zenitmusic/custom_TWIPR/robot_blackboard/sensor_board.png

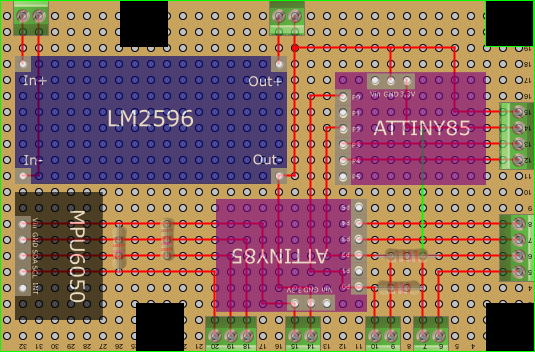
robot_blackboard/sensor_board.png
