zenitmusic/custom_TWIPR/robot_blackboard/motor_board.png

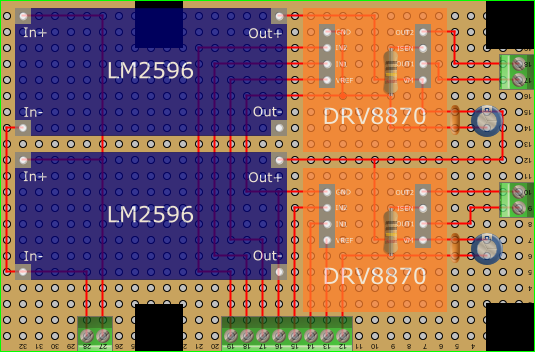
robot_blackboard/motor_board.png
