zenitmusic/custom_TWIPR/README.md

# custom_TWIPR
Custom hard- and software platform for a Two-wheeled Inverted-pendulum Robot
