zenitmusic/custom_TWIPR/robot_schematics.png

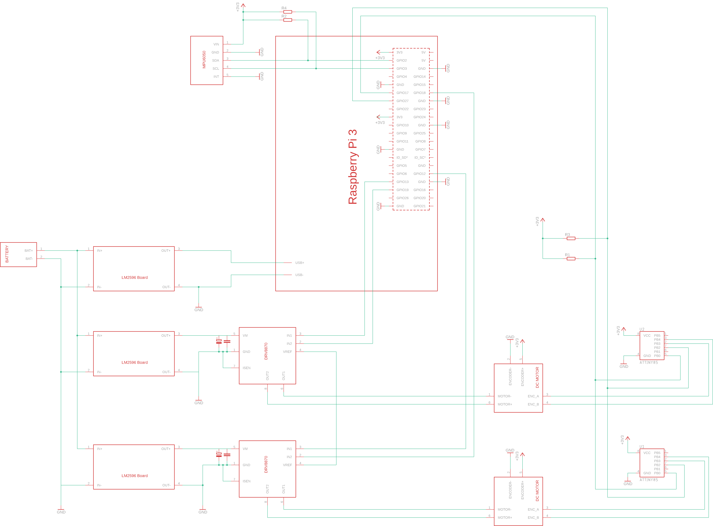
robot_schematics.png
