zenitmusic/custom_TWIPR/robot_eagle/robot.sch

## EAGLE design robot_eagle/robot.sch (2019-02-14)

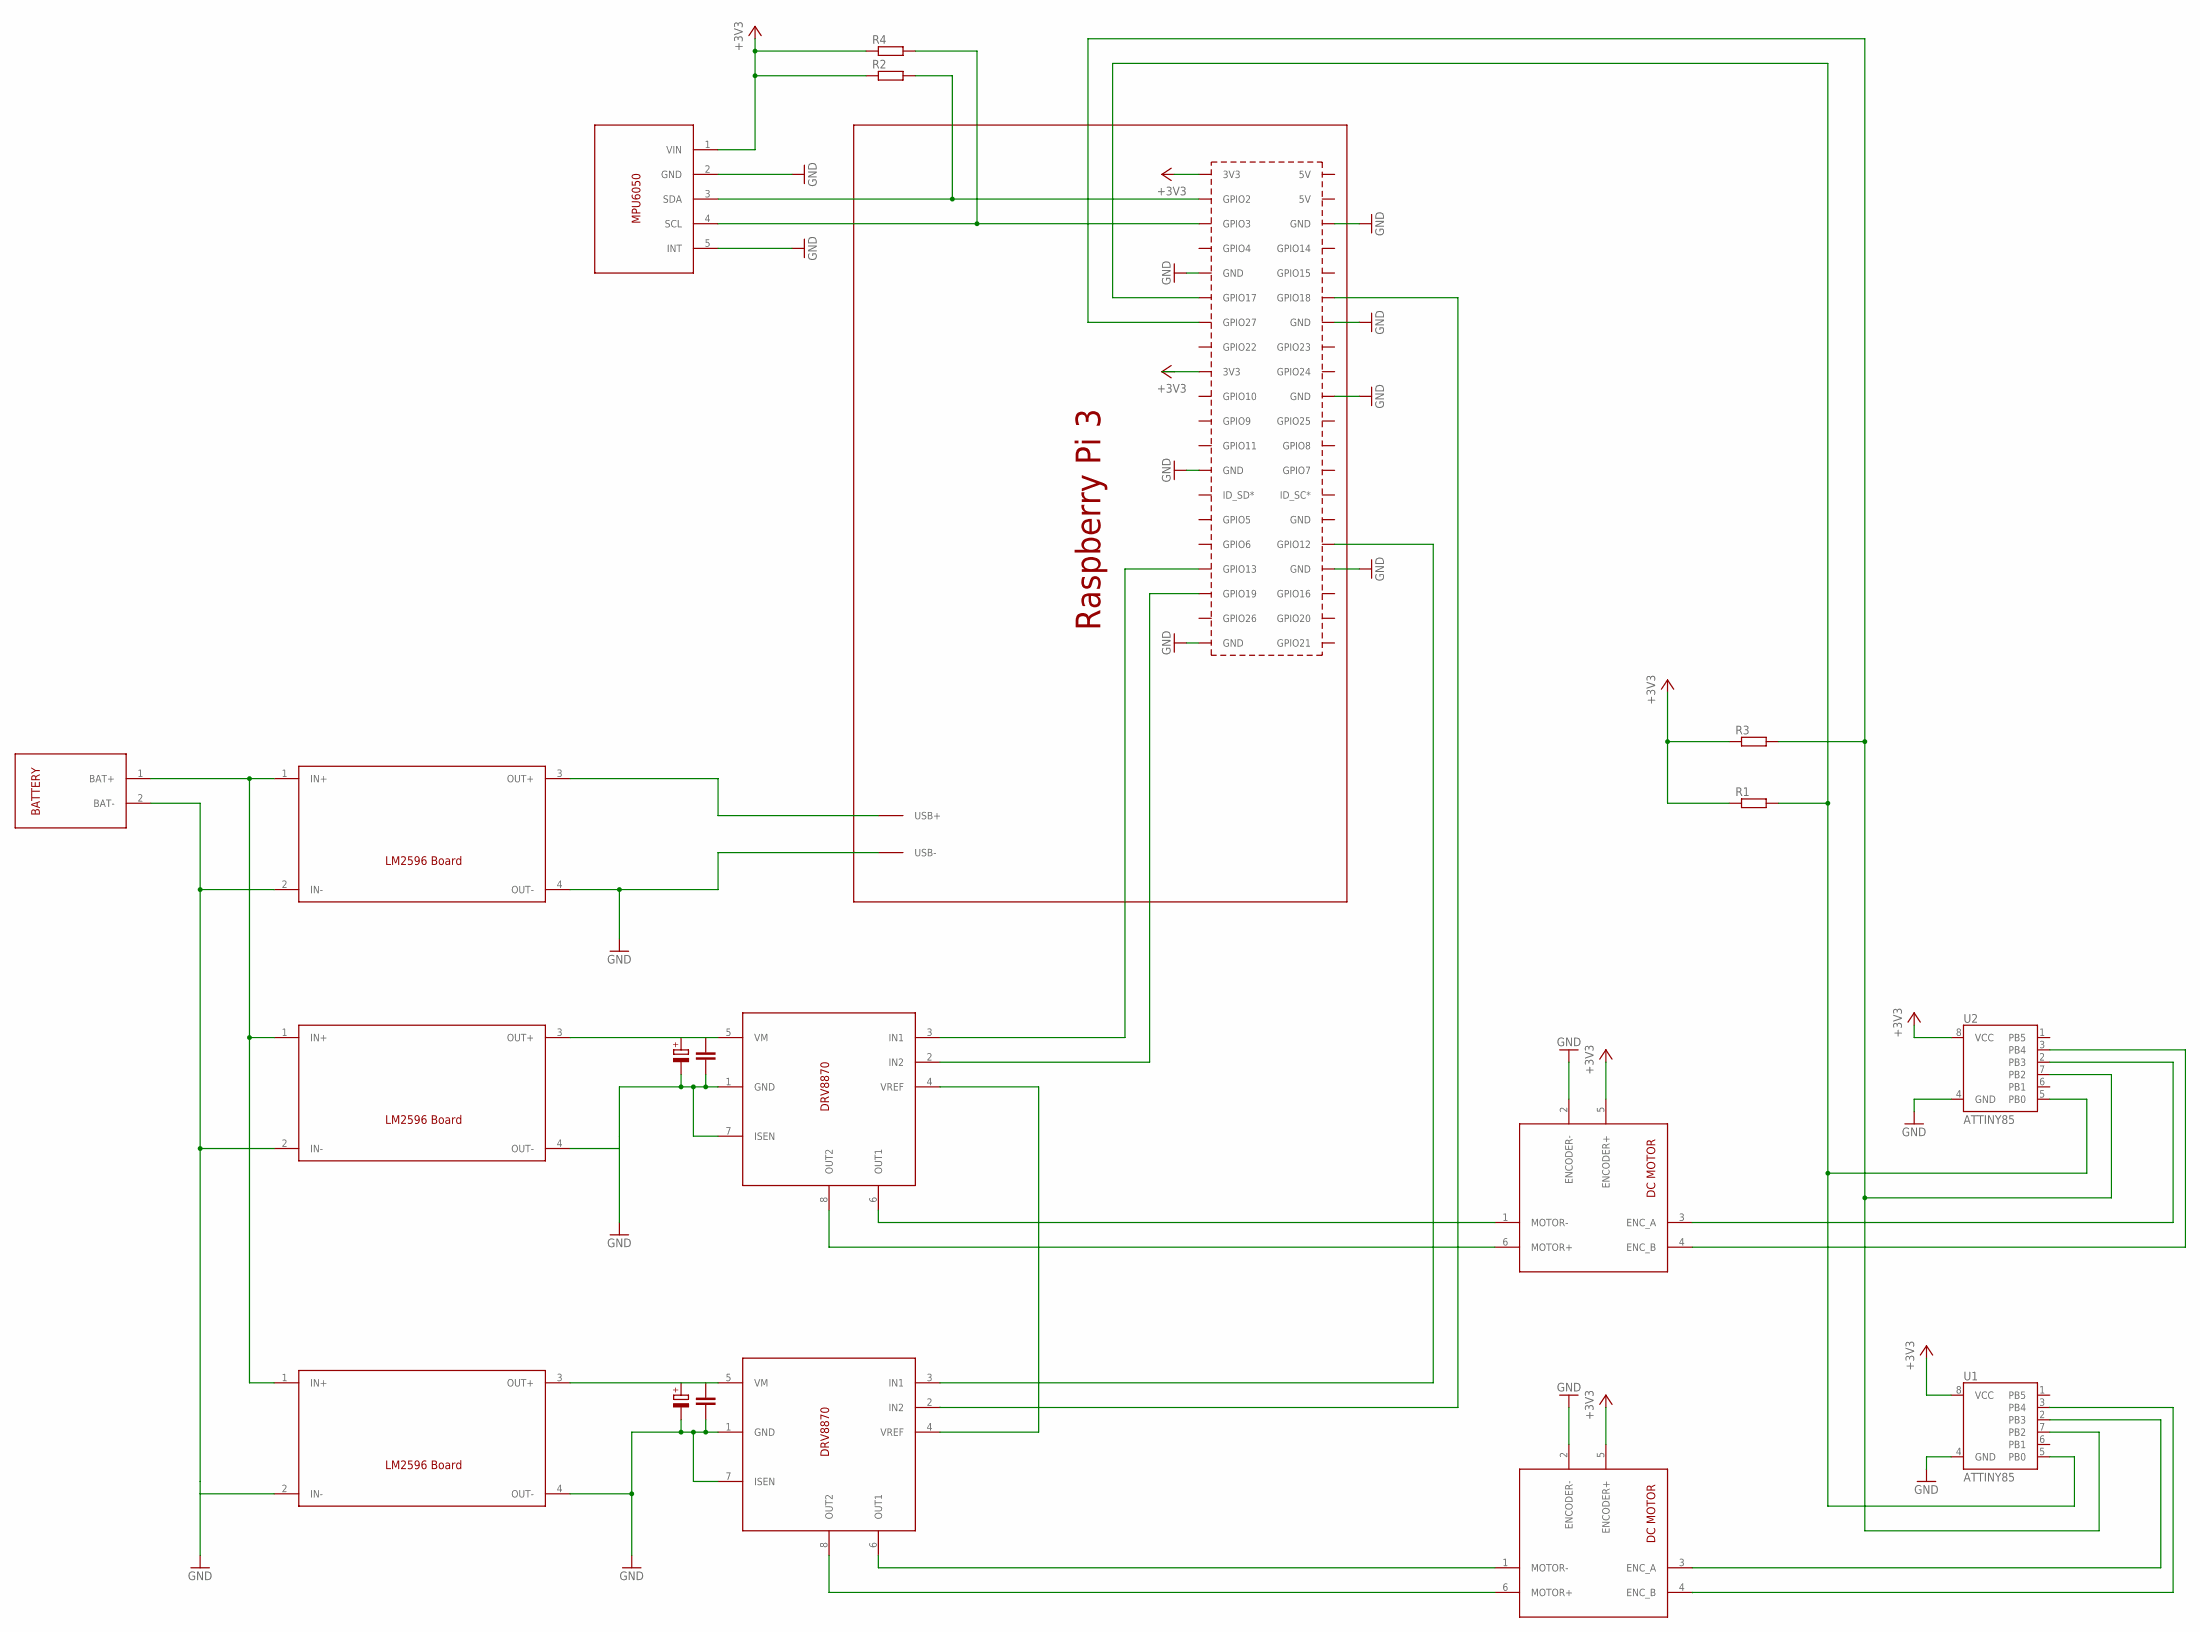
[picture p7: schematic robot.sch]

Parts:
R1, R2, R3, R4: R-EU_0204/7; 0204/7
U1, U2: ATTINY85
U$1: MPU6050; 1X05
U$2, U$3: DRV8870; DIL08
U$4: BATTERY; 1X02
U$5, U$6, U$7: DCDCCONV; DIL04
U$8, U$9: DCMOTOR; 1X06

Connections:
5V: U$7.3 (OUT+)
8V: U$2.5 (VM), U$3.5 (VM), U$5.3 (OUT+), U$6.3 (OUT+)
+3V3: R1.1, R2.1, R3.1, R4.1, U1.8 (VCC), U2.8 (VCC), U$1.1 (VIN), U$8.5 (ENCODER+), U$9.5 (ENCODER+)
GND: U1.4 (GND), U2.4 (GND), U$1.2 (GND), U$1.5 (INT), U$2.1 (GND), U$2.7 (ISEN), U$3.1 (GND), U$3.7 (ISEN), U$4.2 (BAT-), U$5.2 (IN-), U$5.4 (OUT-), U$6.2 (IN-), U$6.4 (OUT-), U$7.2 (IN-), U$7.4 (OUT-), U$8.2 (ENCODER-), U$9.2 (ENCODER-)
unnamed: U$4.1 (BAT+), U$5.1 (IN+), U$6.1 (IN+), U$7.1 (IN+)
unnamed: U$2.4 (VREF), U$3.4 (VREF)
unnamed: U$2.8 (OUT2), U$8.6 (MOTOR+)
unnamed: U$2.6 (OUT1), U$8.1 (MOTOR-)
unnamed: U$3.8 (OUT2), U$9.6 (MOTOR+)
unnamed: U$3.6 (OUT1), U$9.1 (MOTOR-)
unnamed: U1.3 (PB4), U$9.4 (ENC_B)
unnamed: U1.2 (PB3), U$9.3 (ENC_A)
unnamed: R1.2, U1.5 (PB0), U2.5 (PB0)
unnamed: R3.2, U1.7 (PB2), U2.7 (PB2)
unnamed: U2.3 (PB4), U$8.4 (ENC_B)
unnamed: U2.2 (PB3), U$8.3 (ENC_A)
unnamed: R2.2, U$1.3 (SDA)
unnamed: R4.2, U$1.4 (SCL)
